hyunjinkim1112/r2auto_nav_CDE2310/Documentations/Mechanical_Files/Launch Tube_.stl

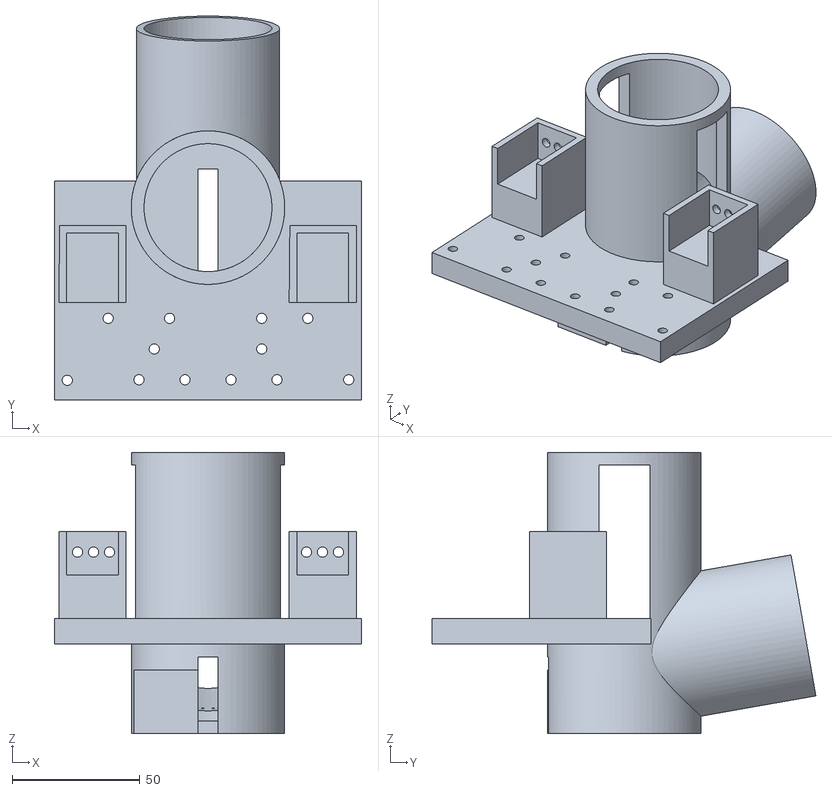
[picture p8: CAD file, 2025-04-20]
Documentations/Mechanical_Files/Launch Tube_.stl
120.0 x 150.0 x 110.0
