hyunjinkim1112/r2auto_nav_CDE2310/(threads)

Thread 1 (2025-03-22):

Integrate thermal camera node with coordinator node

hyunjinkim1112, 2025-03-22:
```
`**Algorithm**`
while (!map the entire environment)
        if (closest frontier reached)
             rotate 360 degrees and store temperature data every 45 degrees
             if (temp > min heat source threshold)
                   record angle with max temp reading
                   set direction toward the recorded heat source
             else if (temp > activation heat source threshold)
                   pose your robot closer to the heat source
                   activate firing sequence
                   record the approximate location of the heat source using a marker
```

AscendedSky, 2025-04-22:
Finished adding in final version. This issue is hence resolved.

Closed 2025-04-22.

Thread 2 (2025-03-22):

Frontier Wavefront Small Maze Issue

AscendedSky, 2025-03-22:
Frontiers are auto completed or do not generate in a maze smaller than 1x1. Potential fixes are increasing the resolution of the occupancy grid, rasterizing laser range to something shorter, decrease goal tolerance, decrease minimum distance of frontier detection.

AscendedSky, 2025-04-22:
This issue has been resolved by implementing the above suggestions in our Navigation 2 Parameters, SLAM Toolbox parameters, and our Frontier Detection parameters. As such, this issue has been resolved.

Closed 2025-04-22.

Thread 3 (2025-04-02):

Goal Reached Infinite Loop in Frontier Wavefront

AscendedSky, 2025-04-02:
The issue is that sometimes that goal is reached instantaneously, so robot gets stuck in the same spot with the same goal being generated. Only encountered in simulations and issue is quite hard to replicate. A potential fix is to add a timer to check whether goal is completed in less than 0.5 seconds, then to restart topic subscriptions or pass handle to r2autonav.

Thread 4 (2025-04-17):

Frontier Navigation Goal Aborted Locking Cmd_vel topic from receiving

AscendedSky, 2025-04-17:
Whenever a frontier goal is aborted by the Navigation 2 Stack, it sometimes stops our backup navigation "r2auto_nav_modified" from publishing cmd_vel commands. We suspect this is due to the thread for the cmd_vel topic being mutex locked by the Navigation 2 Stack. One possible fix could be restarting our frontier navigation node "Auto_mapper", but as this fix has not been tested, this issue will remain unresolved.
