hyunjinkim1112/r2auto_nav_CDE2310/Documentations/Mechanical_Files/Launch Tube Drawing.pdf

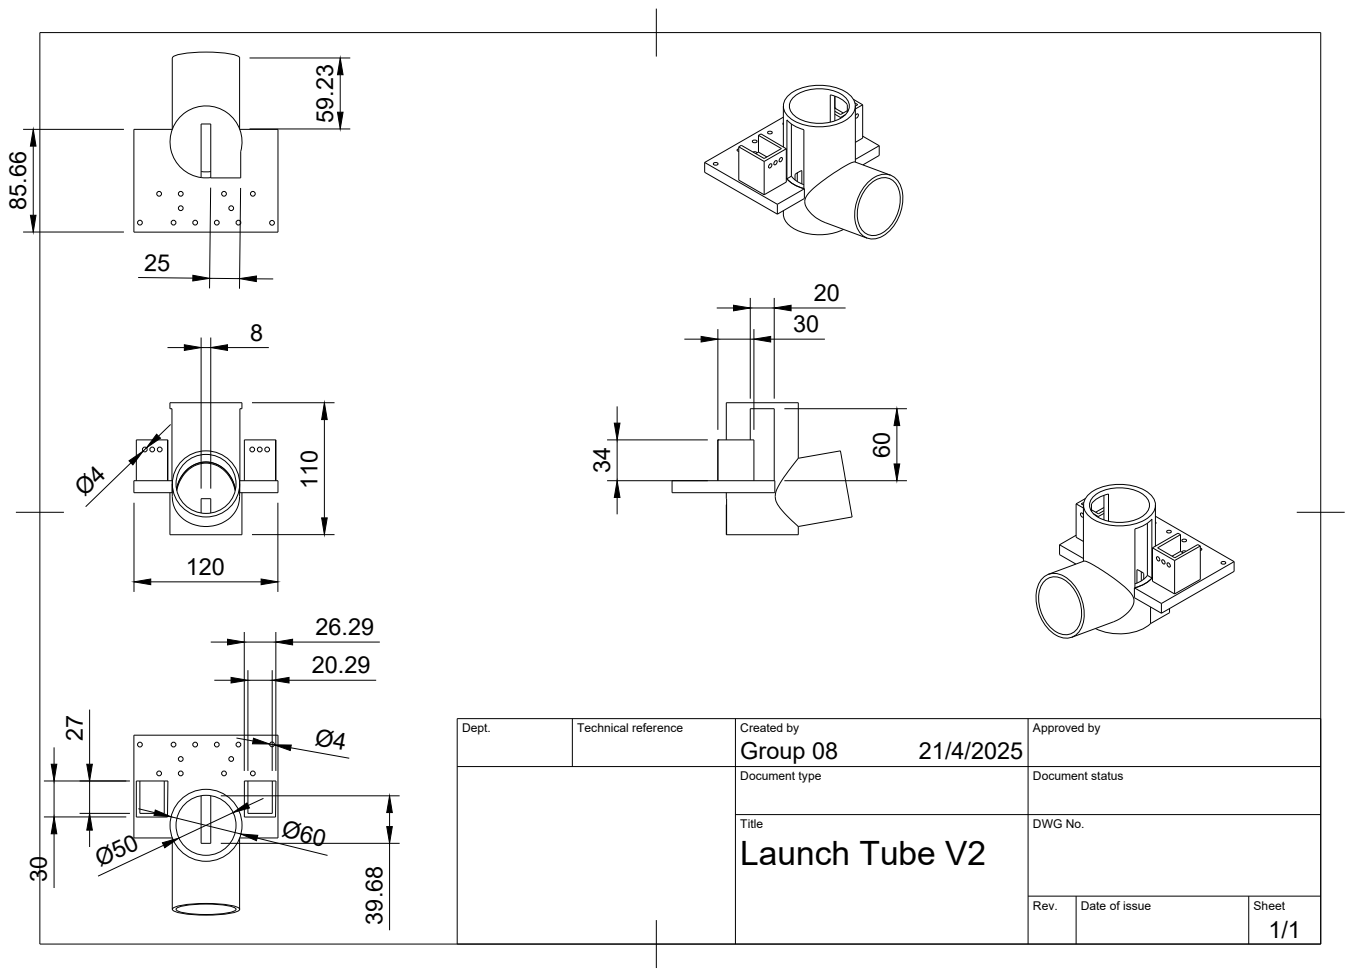
[picture p9: page 1]

Dept. | Technical reference | Created by Group 08 21/4/2025 | Approved by

Document type | Document status

Title Launch Tube V2 | DWG No.

Rev. | Date of issue | Sheet 1/1
