hyunjinkim1112/r2auto_nav_CDE2310/(commit log)

2025-03-13 Created motor_driver.py
    Motor Driver Logic
2025-03-14 Update motor_driver.py
    Added ROS 2 Node functionality
2025-03-23 Added heat source marker and redetection in coordinator.py
2025-03-27 added motor_driver_new.py
2025-04-01 edited motor_driver_new.py to incorporate servo code
2025-04-01 small changes on motor_driver_new.py
2025-04-08 Update coordinator.py
    Added full system functionality. Only missing backup code for ramp detection.
    [coordinator.py]
2025-04-08 Update motor_driver_final.py
    changed enable pin
2025-04-08 Created production heat_detection_node
2025-04-08 Create production motor_driver_final
2025-04-08 Update heat_detection_node
2025-04-17 Update coordinator_node.py
    fixed some bugs
    [coordinator_node.py]
2025-04-21 Rename Documentations/Launch Tube_.stl to Documentations/Mechanical_Files/Launch Tube_.stl
    [Launch Tube_.stl]
2025-04-22 Create v1.0.0 nav2_params_final.yaml
    Final Navigation 2 Parameters using in our ZelephantBot. Do ignore the comments as they were primarily used to keep track of changes made.
2025-04-22 create v1.0.0 motor_driver.py
    This program is the final motor_driver code used in our ZelephantBot.
2025-04-22 create heat_detection_node.py
    This is the final heat_detetection_node program used in our ZelephantBot.
